zongr-ce/8_bit_CPU_FPGA/README.md

This was a school project that helped me to learn a whole lot about how computers work (from logic gate to registers/ALU to control unit).
