zongr-ce/8_bit_CPU_FPGA/Design_sketch.pdf

A GRACE ZONGO | BE : | Ability to | Read Register content
1/16/2024 | WE : | Ability to Write on register

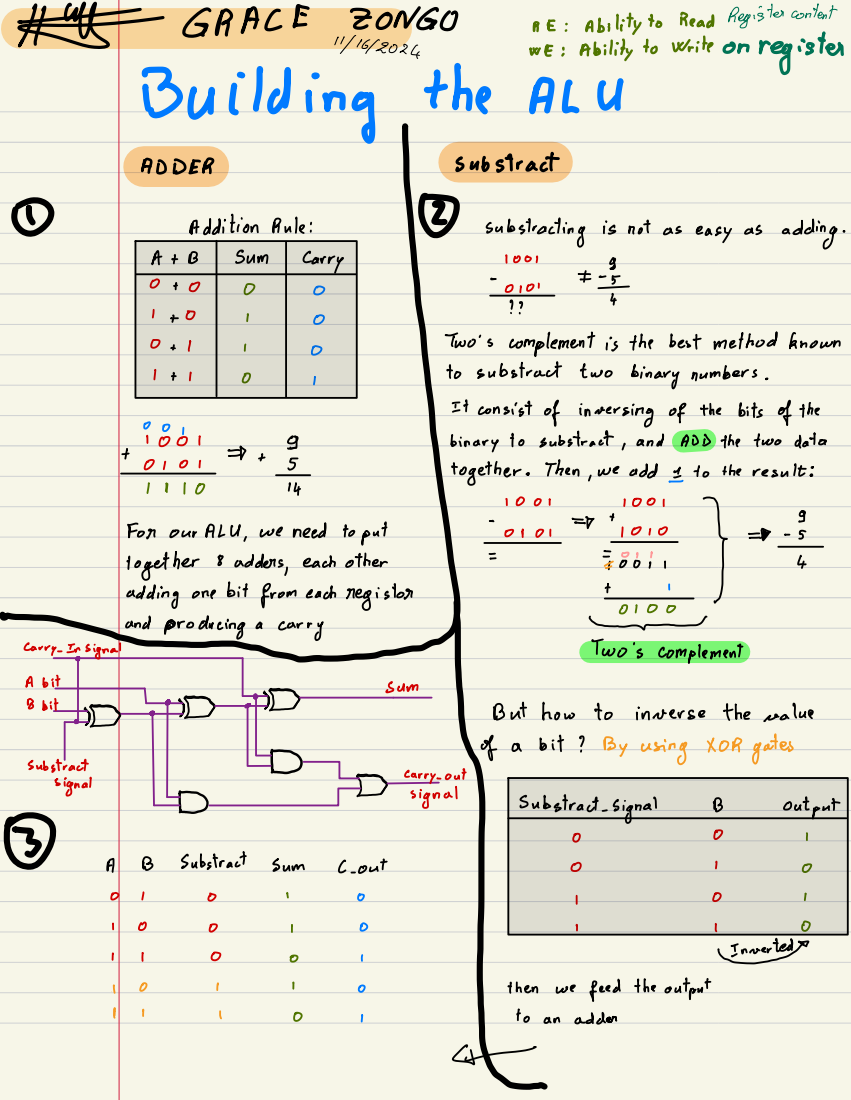
[picture p23: page 1]
Building the AL4; ADDER; Substract; Addition Rule :; ② substracting is not as; easy as; adding. A + B; Sum; Carry; iii; Two's complement is the best method; known; It consist of inversing of the; bits; of the; binary to substract ,; and; ADD the two; data +; together.; Then ,; we need to put; = & =Bad; -g together 8 adders,; each other; adding one bit from each register; Carry-; In Signa; and producing a; carry; -complement A bit; B bit; But how to; inverse; the value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

to substract two binary numbers .

For our ALU ,

we add 1 to the result:

By carry - out

# ALL Test:

+

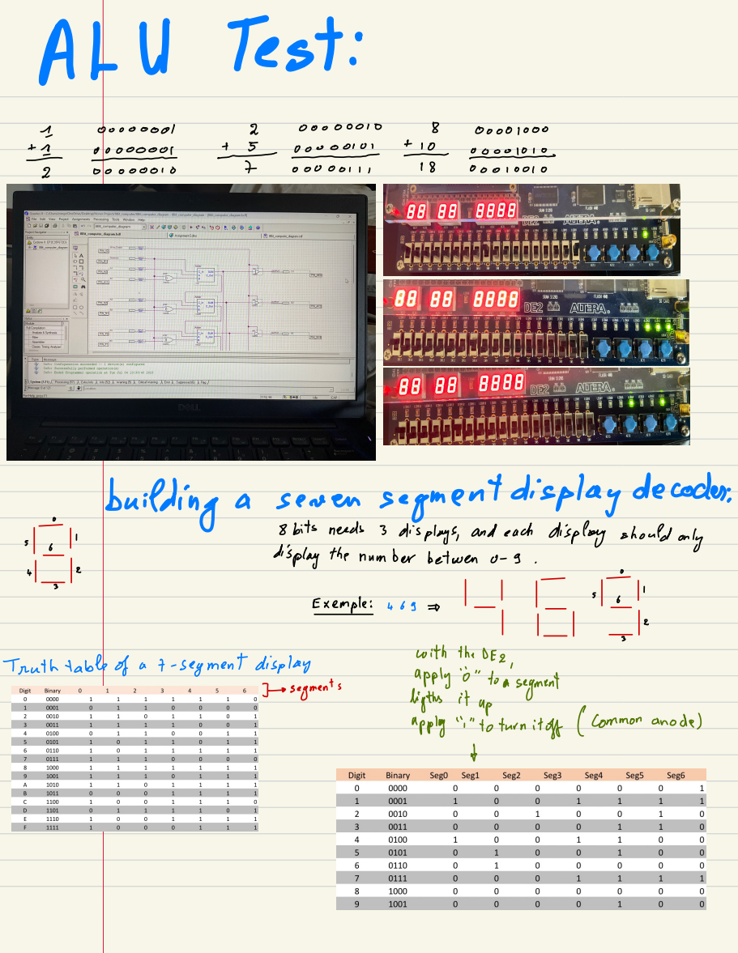
[picture p24: page 2]
building a; seven segment display decoder:; = bits needsa; displays,; and each display should; only display the number betwen 0-9; Exemple :; Truth table of a; +-segment display; Isegments; apply" to a

with the DE2 ,
segment ligths it
apply", "to turn itof (Common anodel

## Let's build a

# each segment based on the

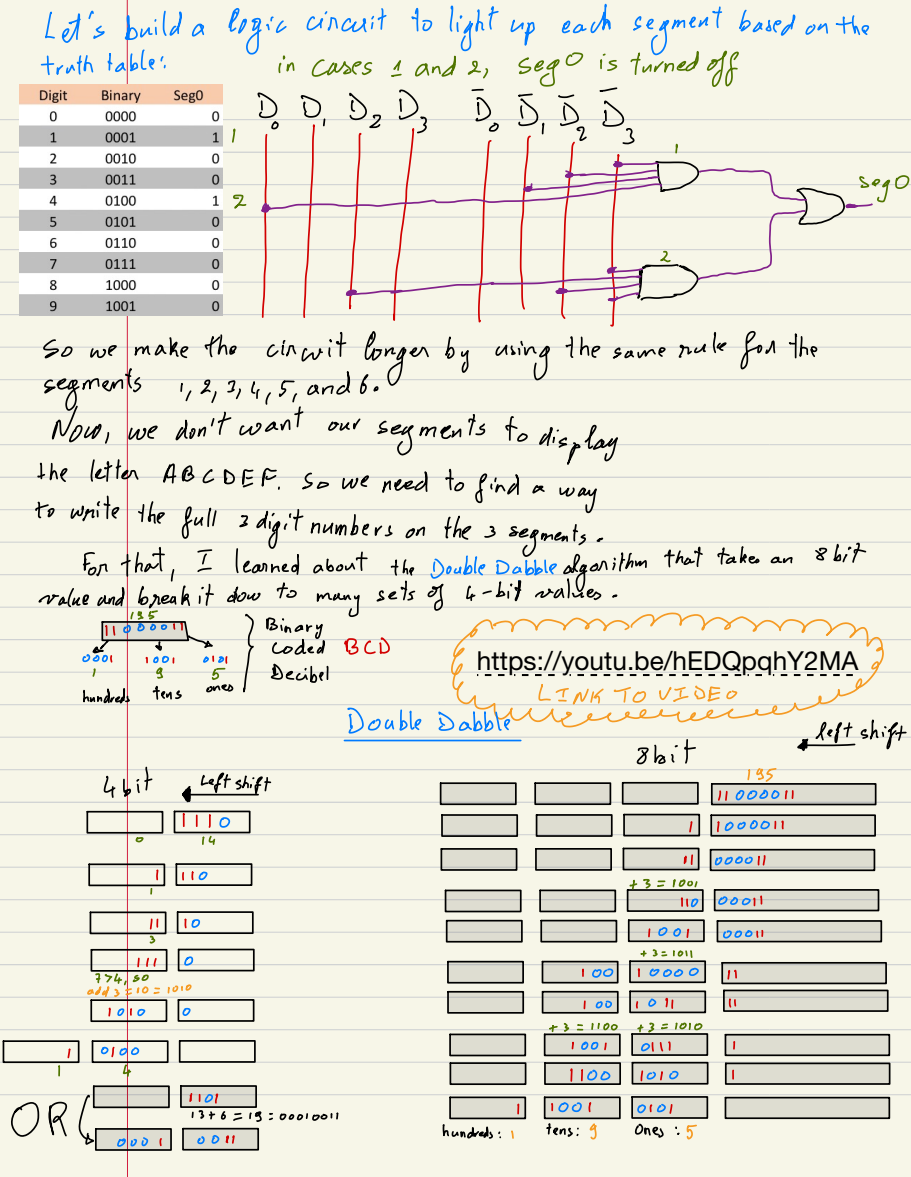
[picture p25: page 3]
truth table :; in cases 1 and 2,; Sego is turned off -; make the; circuit longer by using the same rule for the; Segments 1; and 6 .; Now,; don't want our; segments to display; way to write; the full s; digit numbers on; the 3 segments-; for that ,; I learned about the Double Dabble algorithm that takes an; bit; value and; break it dow to; Binary; coded BCD & Decibel; meLINKe eTO VIDEO; Double Dabble; Left shift; 8 bit; 4 bitLeft shift; add 3; hundreds :; tens :; Ones : 5 000

logic circuit to light up

the letter ABCDEF.

So we need to find a

sets of 4-bil values
many

https://youtu.be/hEDQpqhY2MA

In General | Truth table

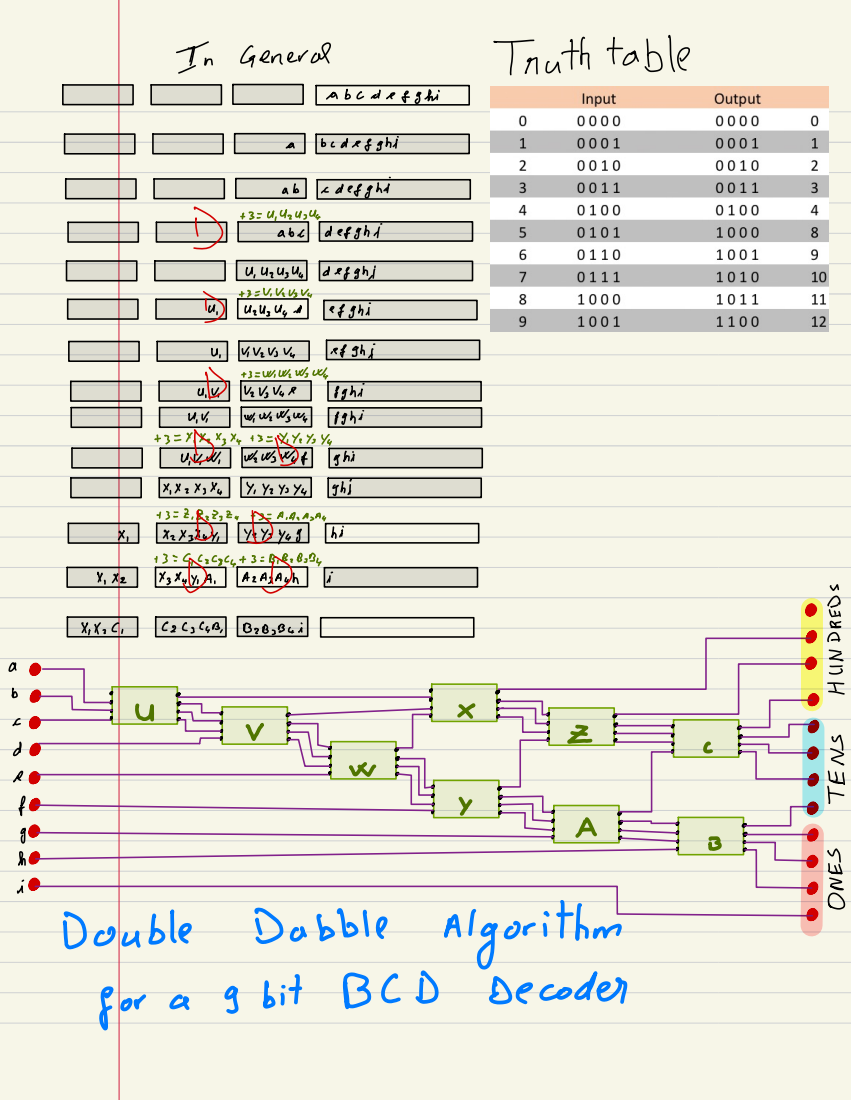
[picture p26: page 4]
abcdsfgh; bcdefgh; ab defgh; defin /; deggn,; My Kelly4e&; eggni; Y VVV; efgh ;; + 3 = W, W= Ws We aDD revue; =XXYshi; X, XzXX4; YeY Y; -SEAAT; 3:SBB,; C2ClB,; BaByB4i; · Double; Dabble; Algorithm; for a; 9 bit BCD; Decoder

## Refer to this

## animation for the load

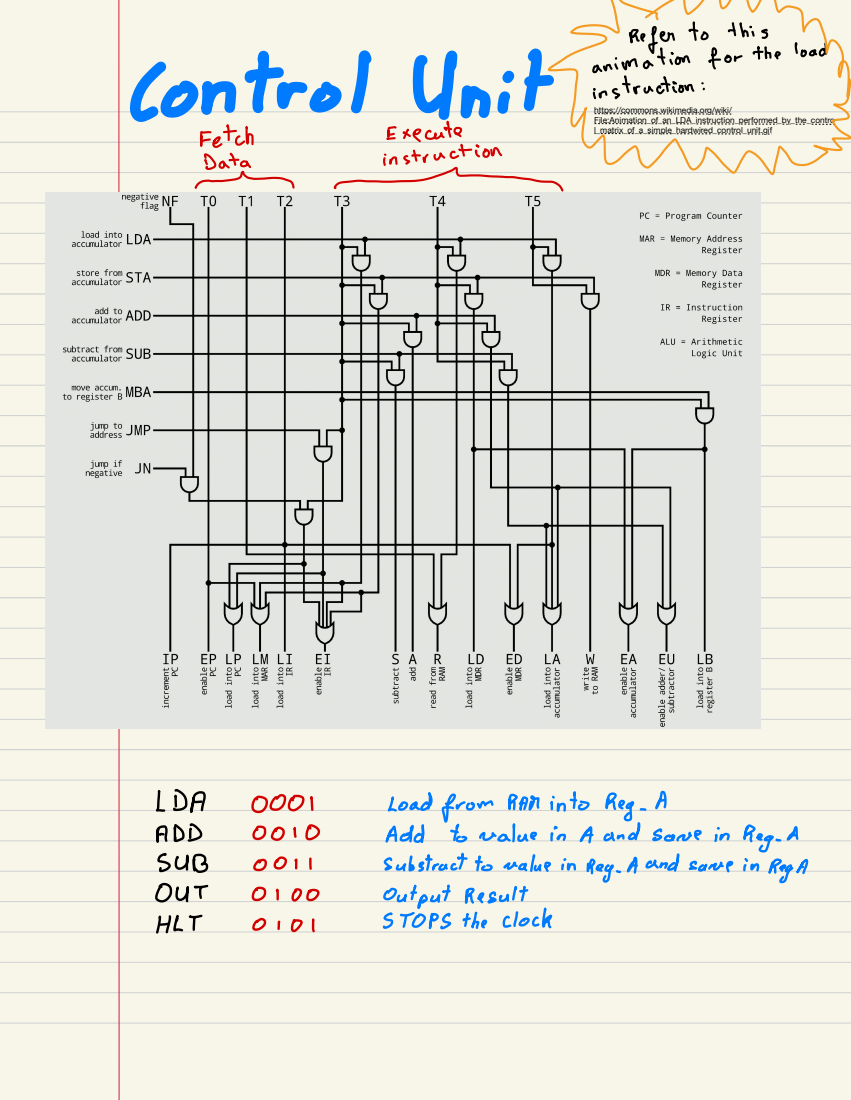
[picture p27: page 5]
Control - instruction; Execute; UnitE; LDA; Load from RAM into Reg ⁻; ADD; Add; to value in A and Save in Reg-; SUB; Substract to value in Rey.; OUT; Output Result; HLT; STOPS the clock

https://commons.wikimedia.org/wiki/
File:Animation_of_an_LDA_instruction_performed_by_the_contro
l_matrix_of_a_simple_hardwired_control_unit.gif

A and same in Rega

TO | st step : | P1 -
RE | -Ench und

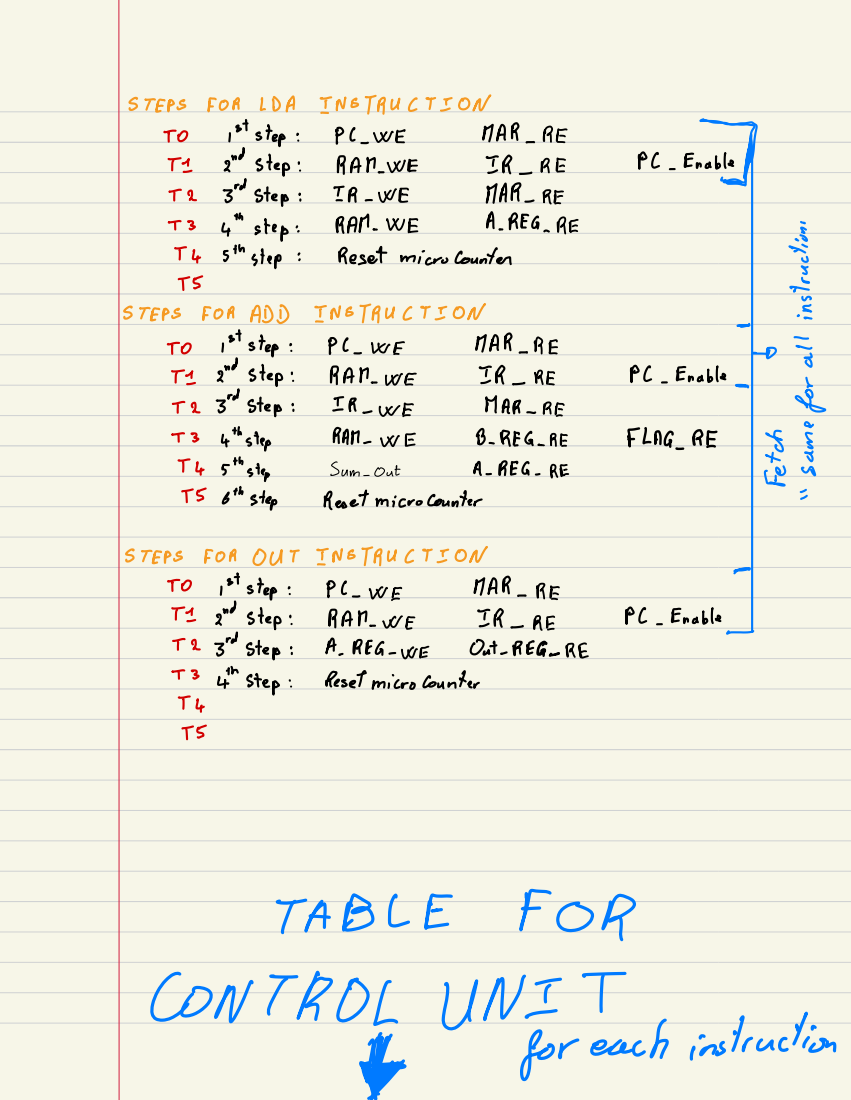
[picture p28: page 6]
STEPS; FOR; IDA; INSTRUCTION; MAR -; Step :; RAM.WE; 3" Step :; MAR-RE; 4" step :; RAM -; REG _; 5th step :; Reset microconten; FOR ADD INSTRUCTION; und; step :; MAR _; RAM-WE; T2 3" Step :; Enable; T34thStep; PAM-WE; REG =; FLAG_; step; Step; Reset; Sum-Out; microcounter; REG- RE; FOR OUT INSTRUCTION; st step :; T1 and Step :; PC-Enable; A. REG-WE; Out-REG-RE; T 34 Step :; Reset micro counter; TABLE; CONTROL UNIT

#for each instruction

Instruction | STEP | CFZF | HLT | MARRARBARFRIR | ARey | ARey | SunT | Subtract
CLR | Flag | BRea

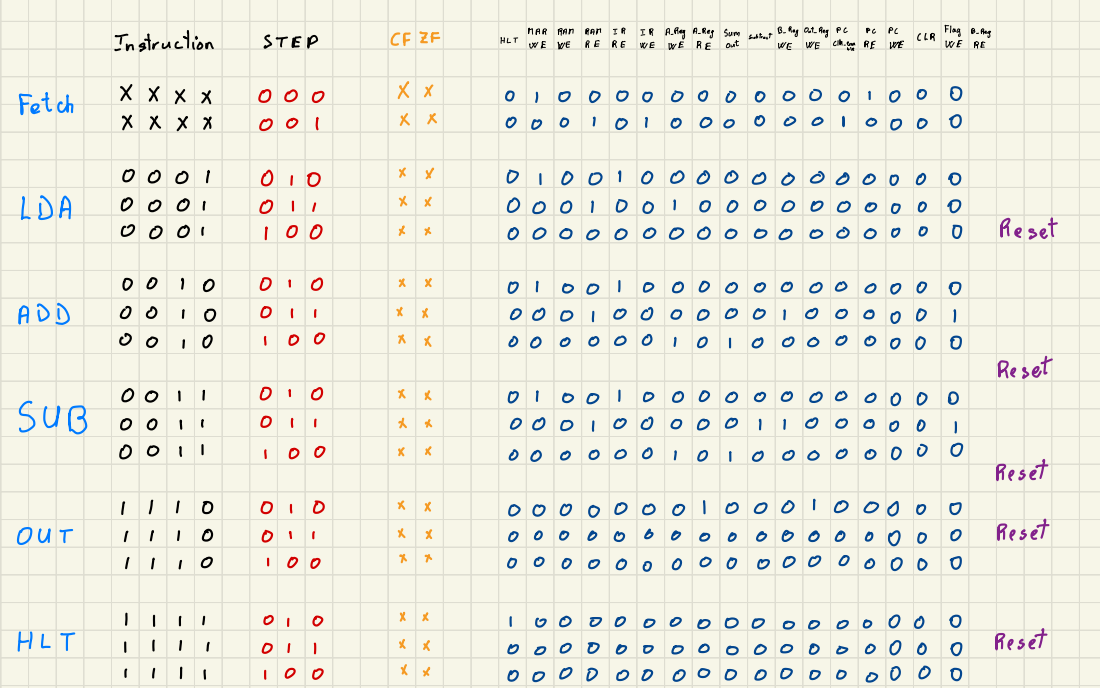
[picture p29: page 7]
Reg; Out-Rey; CIRend; Fetch; XXXX000; XXXX; LDA; Reset; ADD; SUB 0 0; OUT; HLT

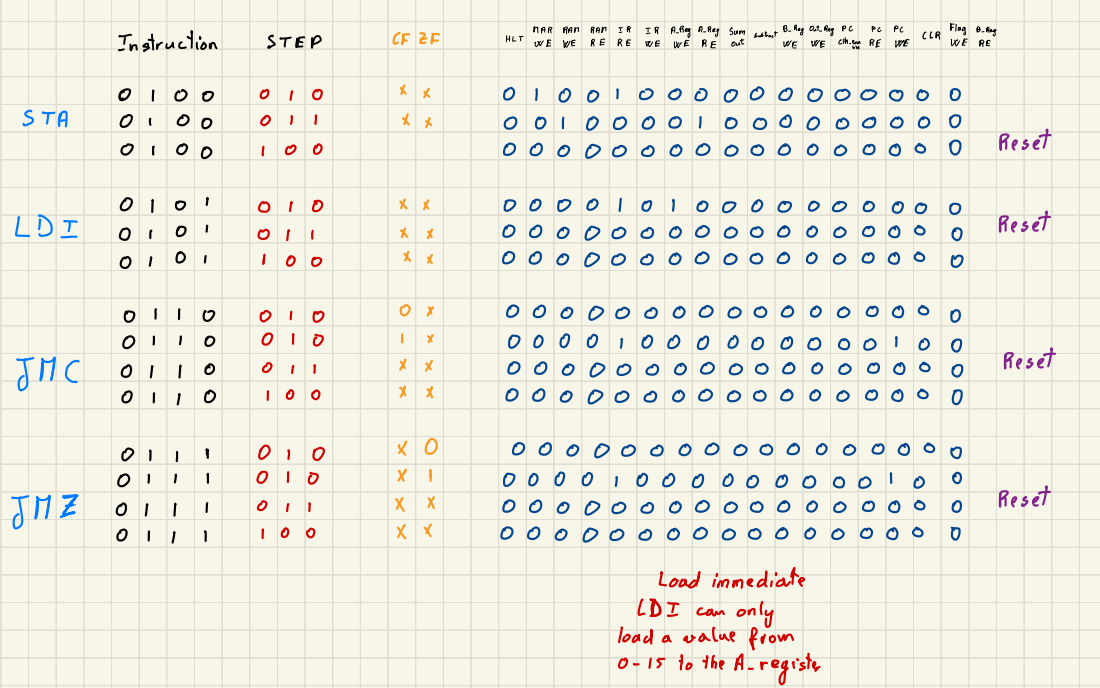
[picture p30: page 8]
MAR; RAM; A Rey; A-Reg; Sum; subtract; Reg; Out-Rey P(; CLR Instruction; STEP; (FEF; HLT; out; Cen RE; Flag; Bea; STA; Reset; LDI; JMC 0

Load immediate
LDI | | can | only
load a | | value | | | from
0-15 | | to | the A-register

TESTING CONTROL UNIT | PIN | ASSIGNMENT
ON | THE | DE2 ALTERA

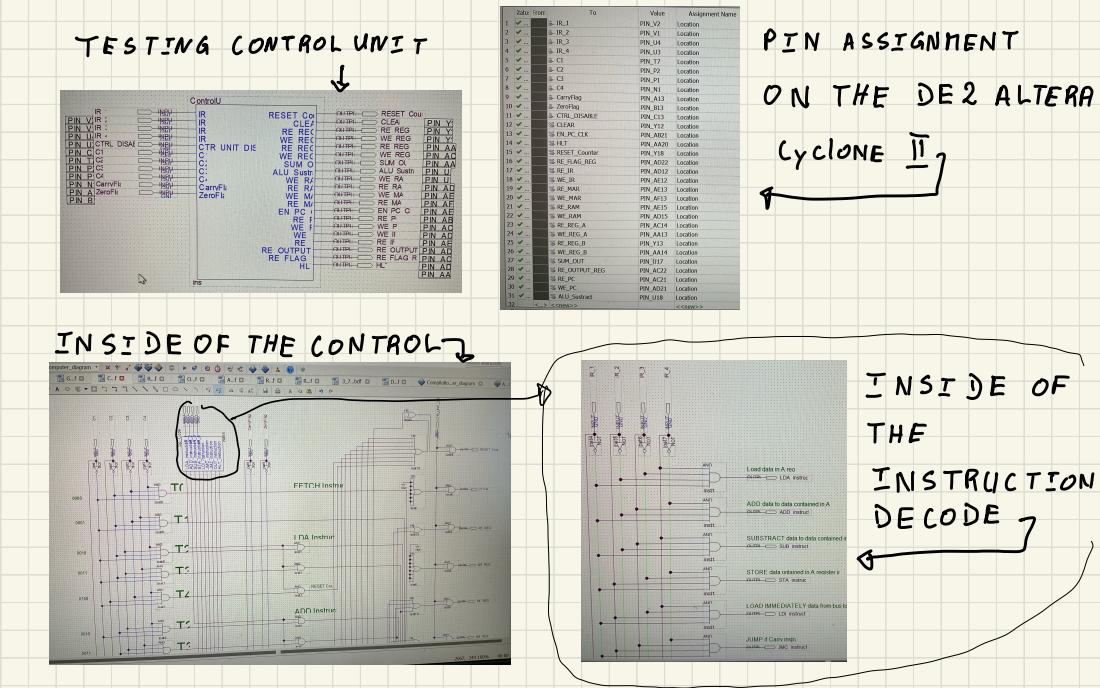
[picture p31: page 9]
letteI; INSIDE OF THE CONTROLT; -IDEOF; THE; INSTRUCTION W.; CODE

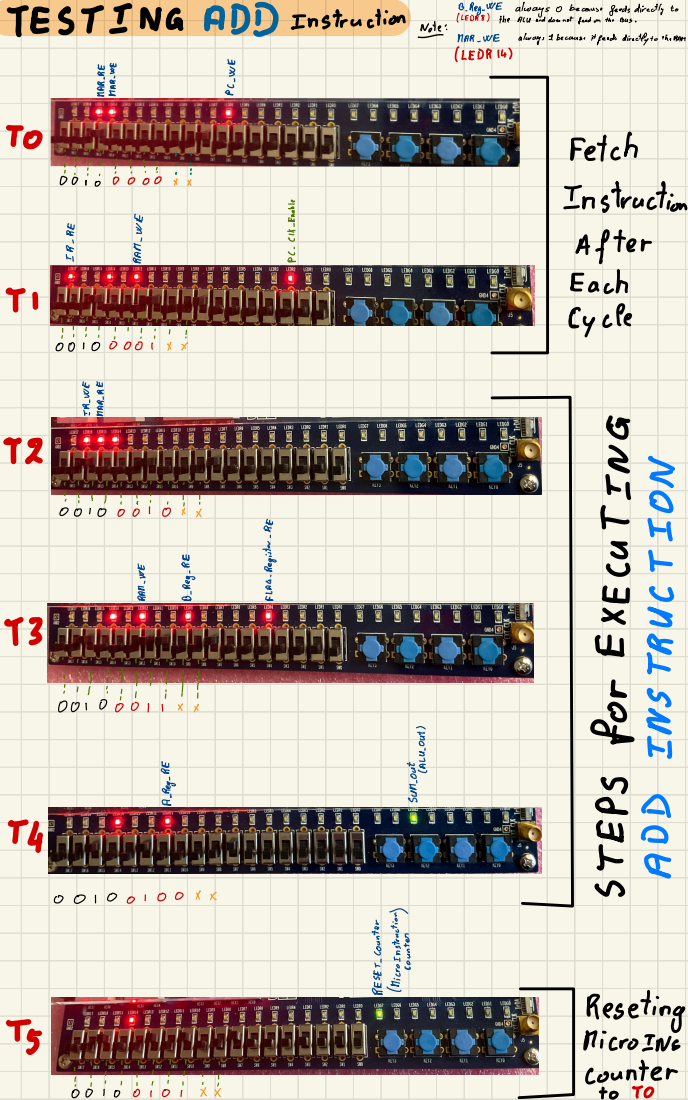
[picture p32: page 10]
--- MAR -RE; unner; --- A_Rey-RE 8 - - - ----; B_Reg _RE ---- X --- X ---; RESET-Counter F; CALU-out) I

u - -- - E : O --- O ---- MAR-WE ---- · F RAM -WE - RAM-WE . O

STEPS for EXECUTING · t ADD INSTRUCTION · -

PC- (Ik-Enable

FLAG -Register -RE

(Micro Instruction) Counter sum-out

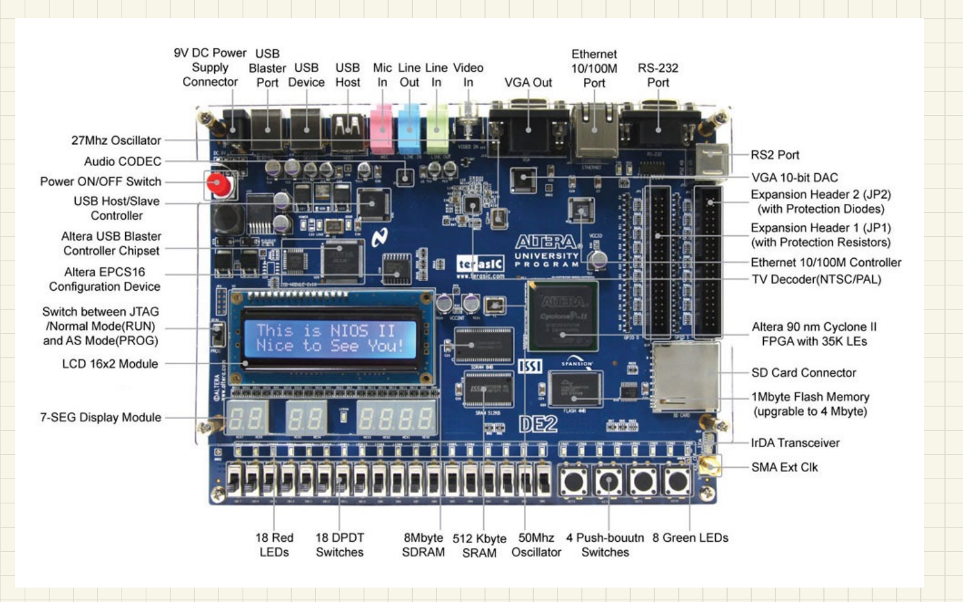
[picture p33: page 11]
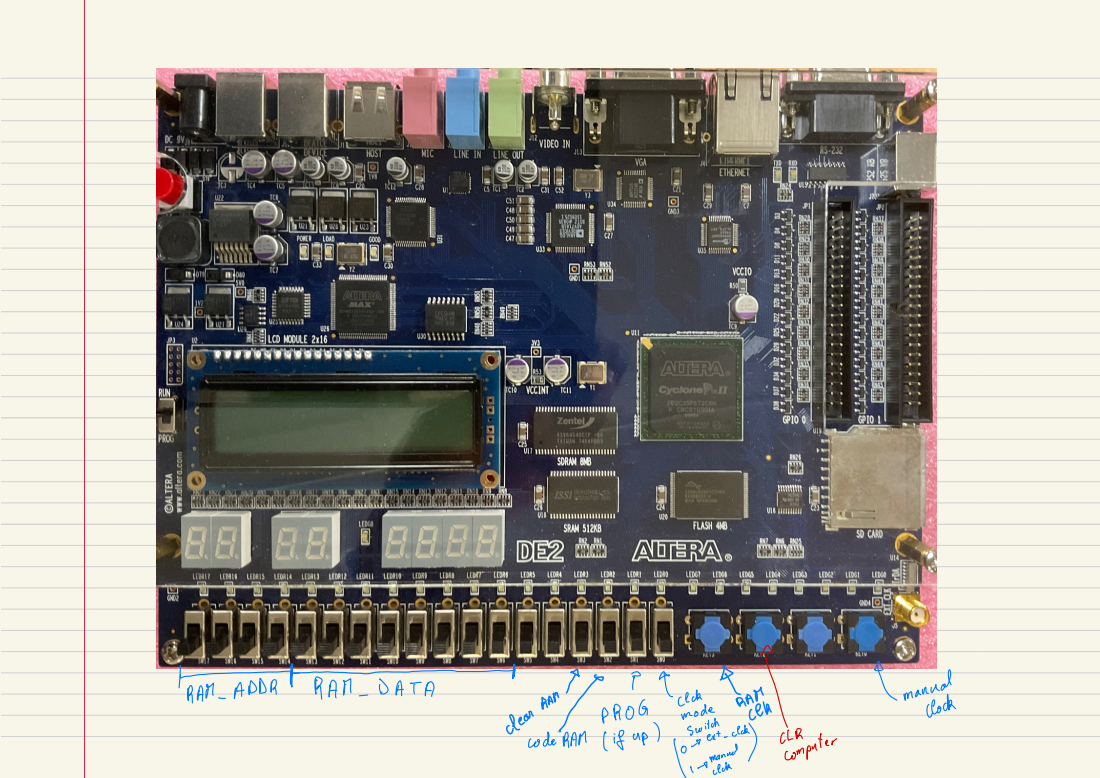
[picture p34: page 12]
_ADDRAM -; Tomr I; manual; clear; mode

DATA dary"prog

codeRAR (if up) pWicc) Cputer

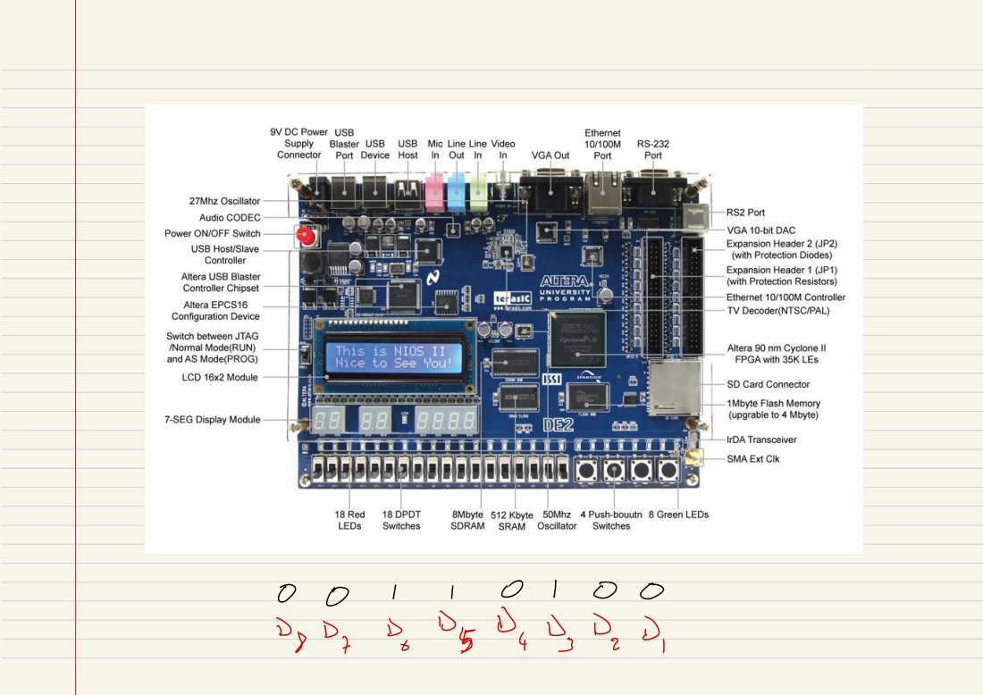
[picture p35: page 13]
0011010 0 GgDy DD D
